FernandaCidE/Obtenci-n-de-se-al-PPG-a-trav-s-de-sensor-de-pulsos/(commit log)

2024-06-03 Pruebas Archivo Excel
    Este archivo corresponde a los datos obtenidos del sensor de pulsos para poder obtener la señal de interés, señal PPG filtrada.
2024-06-03 Modelos 3D
    Modelos 3D de dispositivo para medición de señal PPG
2024-06-03 Create Clip sensor
    Modelo 3D de clip para sensor de pulso
2024-06-03 Clip sensor de pulso
    Modelo 3D para el sensor de pulso utilizado.
2024-06-03 Caja del dispositivo
    Modelo 3D de caja del dispositivo desarrollado.
2024-06-03 Archivo .aia para el desarrollo de la aplicación
    Archivo desarrollado en app inventor para la interfaz de usuario así como el envío de datos a Google Sheets.
2024-06-03 Archivo para el desarrollo de PCB
    Modelo para el desarrollo del circuito PCB
2024-06-03 Archivo arduino
    Archivo arduino que contiene el programa implementado en el proyecto
